Matzel13/BU-Projekt/Bericht/Kapitel/projektarbeit.tex

\section{Herangehensweise}
Für die Umsetzung des Projekts wurde agiles Projektmanagement gewählt. Im Rahmen der agilen Entwicklung wurden wöchentliche Sprints festgelegt, in denen Gruppenmitglieder den Fortschritt der jeweiligen Aufgaben präsentieren. Dies ermöglicht es, bei auftretenden Problemen gemeinsam Lösungen zu erarbeiten. Durch diese Struktur lassen sich Projektziele dynamisch anpassen, wodurch eine schnelle Reaktion auf Probleme oder Engpässe gewährleistet ist.\\

Zu Beginn wurde ein Endziel definiert, das in Abschnitt \ref{sec:vision} beschrieben ist und auf das konsequent hingearbeitet wird. Innerhalb des ersten Sprints konnte erfolgreich eine einfache Datenübertragung zwischen einem ESP32 und einem Arduino-Nano hergestellt werden.\\

In den darauf folgenden zwei Sprints wurde ein erster einfacher Prototyp des Busses entwickelt. Dieser umfasste einen Eindraht-Bus, wobei die Software zu diesem Zeitpunkt lediglich unidirektionale Kommunikation zwischen einem Sender und mehreren Empfängern unterstützte.\\

Im weiteren Verlauf des Projekts wurden Tasten sowie zusätzliche Teilnehmer auf dem Prototyp implementiert. Die Tasten dienten der Simulation verschiedener Busteilnehmer. Jedem Taster wurde ein Mikrocontroller (ATtiny oder ATmega) zugeordnet, um die Adressierung der unterschiedlichen Module zu entwickeln und zu validieren. Das gewünschte Verhalten bestand darin, dass ausschließlich der Mikrocontroller mit der entsprechenden Adresse aktiviert wird, wodurch eine LED zum Leuchten gebracht wird.\\

Anschließend wurde der Prototyp um eine weitere Busleitung erweitert und die differenzielle Datenübertragung angegangen. Hierbei sind einige Schwierigkeiten bezüglich der Hardware aufgetreten. Nach einem Neubau des Prototyps auf dem Breadboard und Reduzierung der Teilnehmer aufgrund von Platzmangel auf dem Breadboard ließ sich ein Keypad-Modul und der Hauptcontroller aufbauen (Abb. \ref{prototyp}). \\
Mit diesem Stand des Prototyps lässt sich ein 2x2 Keypad beliebig belegen und zum Beispiel eine PowerPoint-Präsentation steuern.

\begin{figure}[H]
    \centering    
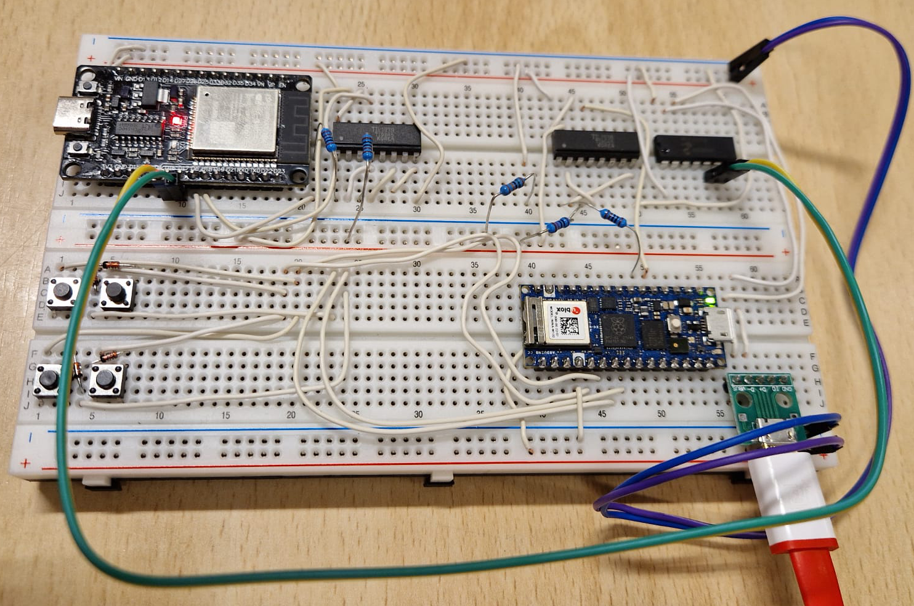
[picture p3: Bericht/Bilder/buPrototyp.png]
    \fbox{}
    \caption{Entwicklungs-Prototyp zum Stand des Zwischenberichts}
    \label{prototyp}
\end{figure}

Nach Bestellen der PCBs kann ein erster richtiger Aufbau der Module realisiert werden und auch die Funktionalität der Hardware Bedingungen (Pogo-Pin Verbindung und magnetische Halterung) können nun getestet werden. Die PCBs sind, aufgrund des Budget, teilbestückt bestellt worden, daher werden diese jetzt von Hand final bestückt.

\subsection{Erfolge}
\subsubsection{Synchronisation}
Zur Synchronisation des Empfängers mit dem Sender haben wir eine Funktion geschrieben, welche bei einem HIGH-Value auf dem Bus einen Zeitstempel setzt und sobald der Bus auf LOW fällt, die Übertragungsgeschwindigkeit ausrechnet. Damit wird sichergestellt, dass die übertragenen Bits richtig ausgelesen werden.

\subsubsection{Datenübertragung}
Durch die selbst geschriebene Software lassen sich in der Theorie beliebig große Datenmengen übertragen, solange die Anzahl an Datenbytes im Code festgelegt wurde. In der Praxis sind große Datenmengen vermutlich problematisch, da die Synchronisation nur zu Beginn des Frames stattfindet. Da wir in unserem Projekt nur Eingabewerte übertragen, welche 8 Byte nicht überschreiten werden, haben wir uns auf ein Maximum von 8 Byte festgelegt. Sollte sich an einem zukünftigen Entwicklungspunkt herausstellen, dass wir mehr Daten übertragen wollen, lässt sich das leicht anpassen, aber es sollte auch eventuell eine Neusynchronisation überlegt werden. 

\subsubsection{Adressvergabe und Polling loop}
Das Hauptmodul startet eine dauerhafte vordefinierte Abfrage der Adressen. Über die erste abgefragte Adresse wird einem neuen Modul eine Adresse vergeben und diese mit der Art des Moduls in Hauptmodul abgespeichert. Die erhaltenen Werte der Module gibt das Hauptmodul zusammen mit der Modul-Adresse an den PC weiter.

\subsubsection{Input-Mapper Program}
Als Bedienoberfläche wurde ein Programm geschrieben, welches die empfangenen Daten auf die vom Nutzer definierte Keybindings mappt.

\subsubsection{Parallele Entwicklung}
Das parallele Entwickeln war durch das Verwenden des Versionsverwaltungs-Programms \glqq Git\grqq{} und einem zentralen Repository auf \glqq GitHub\grqq{}(https://github.com/Matzel13/BU-Projekt) von Beginn an erfolgreich und hat sich durch die Länge des Projekts gezogen. Durch das Erstellen von persönlichen \glqq Branches\grqq{} konnte jeder Entwickler an seinem eigenen Fortschritt arbeiten und bei Bedarf mit dem Hauptzweig zusammenführen. In Abb. \ref{gitgraph} ist ein Ausschnitt des GitGraphen unseres Repository zu sehen.

\begin{figure}[H]
    \centering    
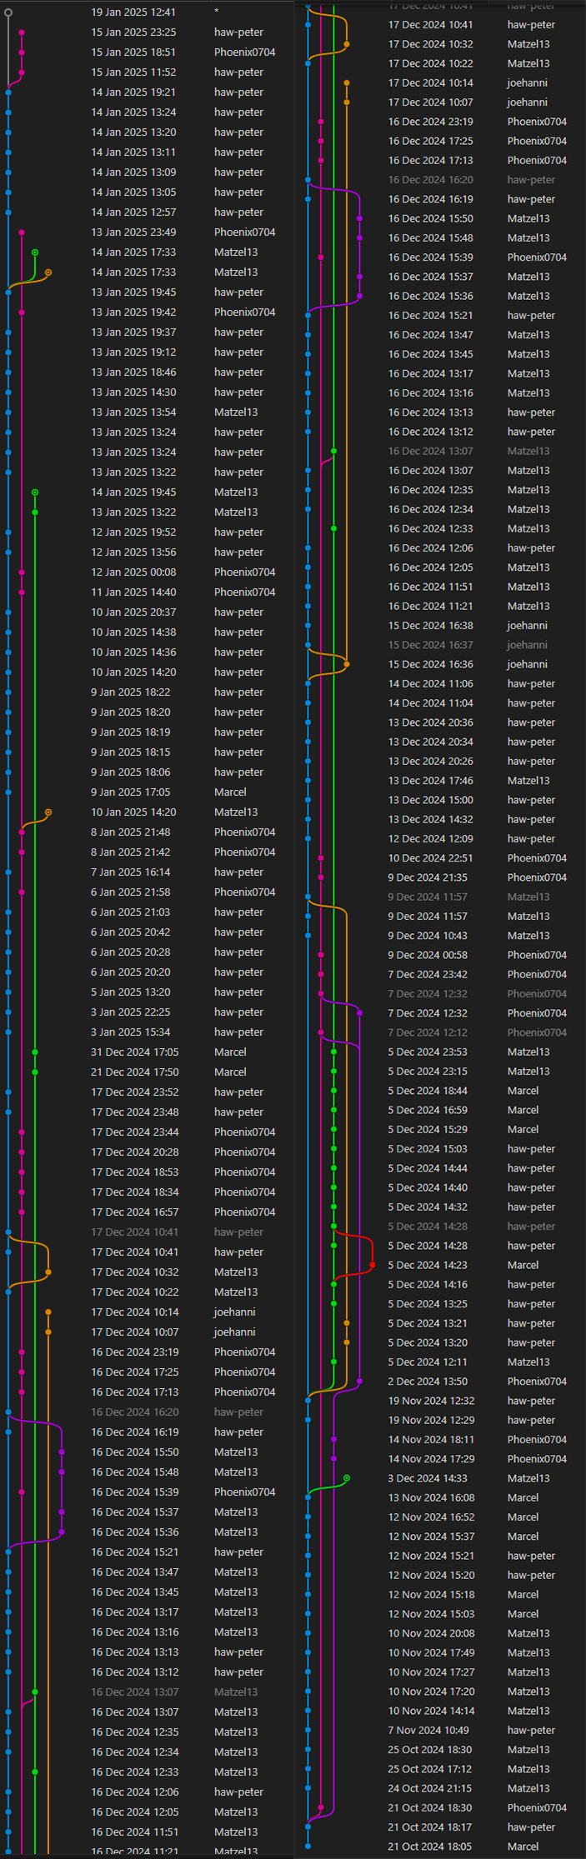
[picture p4: Bericht/Bilder/gitGraph.png]
    \fbox{}
    \caption{GitGraph stand 19.01.2025. Die Linie links stellen die Unterschiedlichen Branches dar. Ein Punkt auf der Linie bedeutet, dass dort ein Commit erstellt wurde. Das Datum ist das Commitdatum und der Name der Person, die den Commit erstellt hat.}
    \label{gitgraph}
\end{figure}

\subsection{Probleme}
\subsubsection{ATtiny und ATmega}
Die eingesetzten Mikrocontroller (ATtiny und ATmega) lassen sich nicht direkt über USB programmieren. Aus diesem Grund wurde innerhalb zwei Sprints versucht, einen eigenen ISP-Programmer (In-System Programmer) zu entwickeln. Trotz vieler verfügbarer Anleitungen und Forenbeiträge zu bereits selbstgebauten Flashern gelang es nicht innerhalb des vorgegebenen Zeitrahmens, einen funktionierenden Programmer zu erstellen. Schließlich wurde ein fertiger ISP-Programmer gekauft, wodurch die Programmierung der Mikrocontroller schnell und erfolgreich möglich wurde.

\subsubsection{Differenzielle Datenübertragung}
Der erste Ansatz zum Erstellen einer differenziellen Datenübertragung war es, dies über die Software zu lösen. Jedoch kam nach gemeinsamer Absprache der Entschluss, dass dies nicht sonderlich förderlich sei und hauptsächlich der Geschwindigkeit des Busses schadet. Bei der Erweiterung des Eindraht Prototypen auf einen Zweidraht Bus mit differenzieller Datenübertragung entstand das Problem, dass in einigen Fällen die Busleitung kurzgeschlossen wird. Dieser Kurzschluss lässt sich durch galvanische Trennung der Teilnehmer vom Bus, ähnlich wie beim CAN und USB, lösen. Um weiterhin mit den zur Verfügung gestellten Produkten zu arbeiten, wurde erstmal ein Optokoppler der HAW getestet. Scheinbar war dieser Optokoppler defekt, da sich die Schaltzeiten im \si{ms} Bereich bewegt haben. Dies wäre ein viel zu hohe Latenz für die Datenübertragung und daher wurden vier mögliche alternative Bausteine bestellt, zwei verschiedene Optokoppler, einen Operationsverstärker und einen digitalen Isolator. Die Optokoppler lieferten ein zufriedenstellendes Ergebnis mit einer Latenz im einstelligen \si{\micro\second} Bereich. Zusätzlich zu den Optokopplern wurde ein Transmitter und Receiver Bauteil entdeckt, da jedoch die Lieferzeit für diese Bauteile sehr hoch ist, werden diese Bauteile vom PCB Hersteller direkt auf das PCB designt, welches das Testen der Bauteile leider nicht ermöglicht. Der aktuelle Prototyp wurde mit diskret aufgebauten Invertierern und Optokopplern realisiert.

\subsubsection{Ungetestete Bauteile}
Wie im vorherigen Absatz erwähnt, werden Bauteile benutzt, die leider im Vorfeld nicht getestet werden können. Daher wurden Alternativen im PCB-Design implementiert, falls diese Bauteile nicht die Erwartungen erfüllen. Bei der Entwicklung der PCB und der Lösung des Problems der differenziellen Datenübertragung werden die Bauteile der SN65LVDXXX Familie benutzt. Aufgrund der erwähnten Lieferzeit konnten die Bauteile nicht getestet werden. Um etwaige Probleme mit den Bauteilen zu umgehen, werden mehrere Jumper ins Design geplant, um die Bauteile mit Optokopplern oder eine externe Testschaltung oder Testbauteil zu ersetzen.

\subsubsection{Krankheit und Lieferzeiten}
Aufgrund von Krankheiten konnte die Gruppe nicht an jedem Termin vollständig arbeiten, oder musste bereits fertige Pläne umstrukturieren. Zusätzlich kam es zu Verzögerungen durch Lieferzeiten von ein bis zwei Wochen der Bauteile.

%Bild von Zeitplan einfügen PETER EDIT: Zeitplan muss aktualisiert werden MARCEL Edit: mache ich immer schon ;) PETER EDIT: Nice, machen wir nachher rein MarcelEdit: klar ;)
%MarcelEdit: die Tabelle muss nochmal finalisiert und eingefügt werden !!!

Einen groben Übersichtsplan des Zeitmanagements ist in Abbildung \ref{zeitplan} zu sehen. Deutlich erkennbar sind die KW44 und KW48, in denen kein Meeting stattfinden konnte. Zusätzlich sind alle Vorlesungszeiten mit im Plan aufgenommen, da die Vorlesungen teilweise genutzt wurden, um am Projekt zu arbeiten. Der Zeitplan dient lediglich einer groben Analyse der investierten Zeit und hat keinen Einfluss auf das Vorgehen.

\begin{figure}[H]
    \centering    
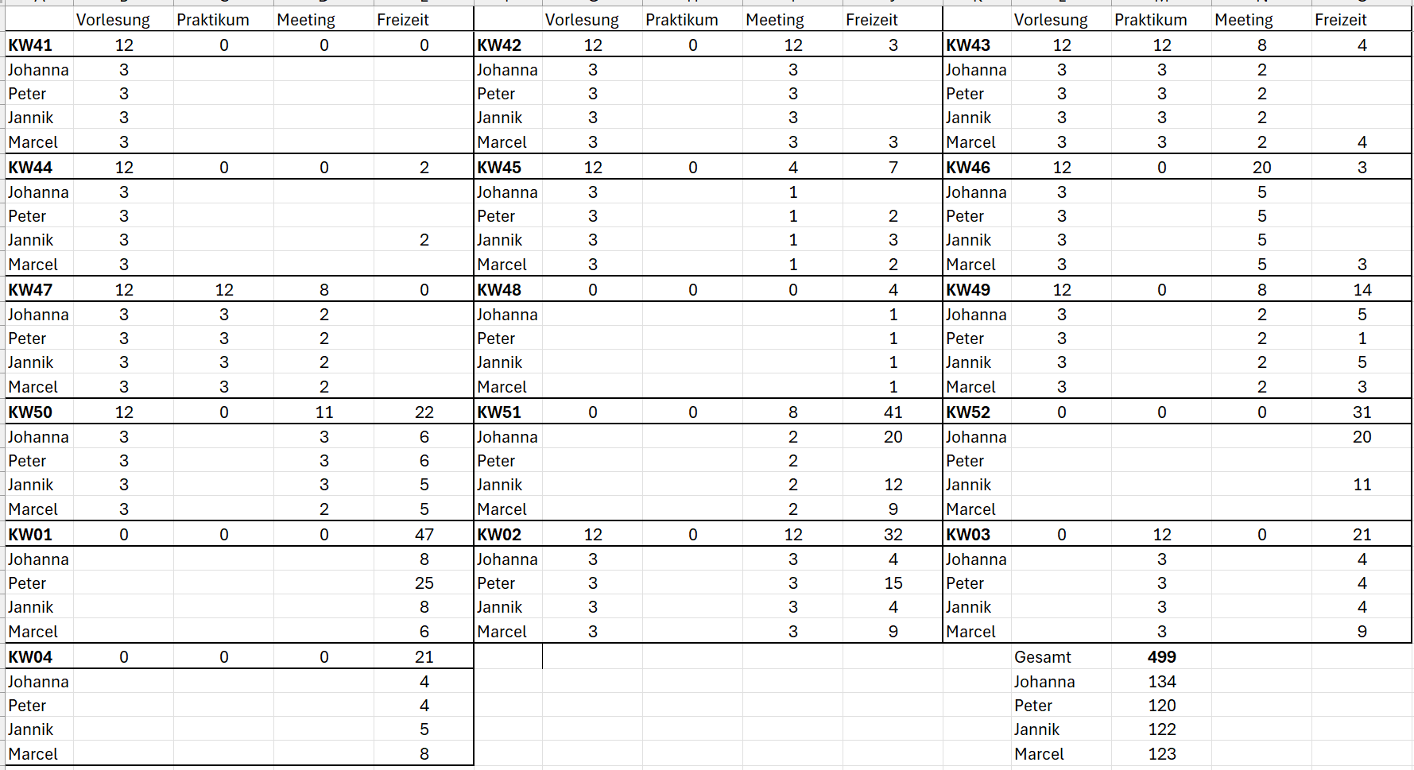
[picture p5: Bericht/Bilder/zeitplanBU.png]
    \fbox{}
    \caption{Zeitmanagement stand 21.01.2025}
    \label{zeitplan}
\end{figure}

\subsection{Budget}
Zur Entwicklung der Testaufbauten und des Prototyps wurden diverse Bauteile bestellt. Da im Anschluss an das Hochschulmodul jedes Gruppenmitglied ein Exemplar behalten wollte, entschieden wir uns das Projekt selbst zu finanzieren. Um die Kosten der Module gering zu halten, wurde bei jeder Entscheidung darauf geachtet, die günstigste Version zu finden. In Abbildung \ref{Finanzen} sind alle Bauteile, die bestellt worden sind, aufgelistet und diese Liste wurde genutzt, um einen Überblick über die Ausgaben zu behalten. Es lässt sich gut erkennen, wie teuer die Modul-Prototypen sind, das Hauptmodul befindet sich derzeitig bei 39,68 € und das Keypad-Modul bei 44,61 €. Diese Preise lassen sich in Zukunft vermutlich noch reduzieren, da die PCBs mit verschiedenen Testcases bestückt sind. In dieser Berechnung sind die Kosten für die Gehäuse nicht berücksichtigt. 

\begin{figure}[H]
	\centering    
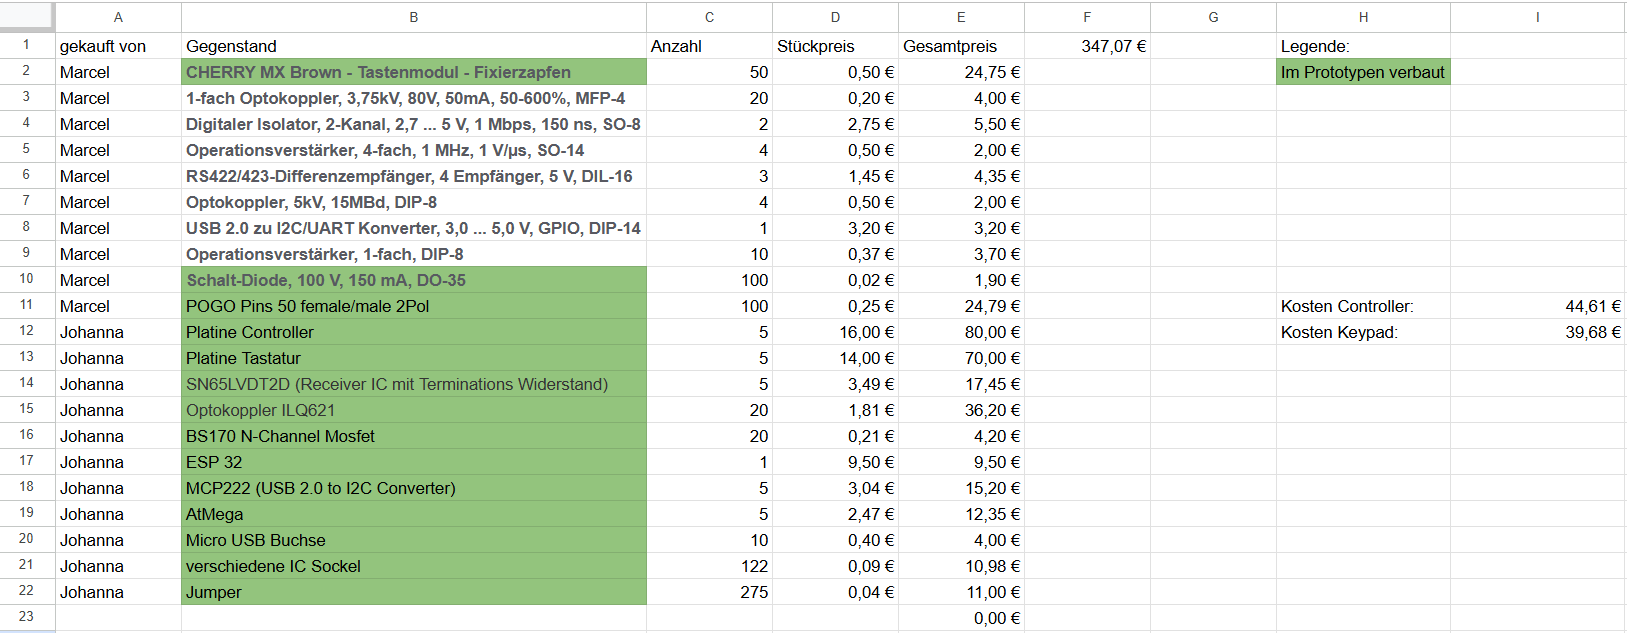
[picture p6: Bericht/Bilder/Finanzen.png]
	\fbox{}
	\caption{Exceltablle der Ausgaben, stand 19.01.2025. Darstellung der gekauften Bauteile und von wem diese gekauft wurden. Mit Grün hinterlegte Felder sind auf dem aktuellen Prototyp verbaute Bauteile. In F1 steht der Gesamtbetrag der bisher investiert wurde}
	\label{Finanzen}
\end{figure}

Das Produkt lässt sich sehr gut mit dem Stream Deck von elgato vergleichen. Bei einer möglichen Vermarktung unseres Produktes kann sich an dem Preis des Streamdeck orientiert werden. Dazu ist in Abbildung \ref{streamDeck} der offizielle Preis des 3x5 Keypad Stream Deck von elgato dargestellt.

\begin{figure}[H]
	\centering    
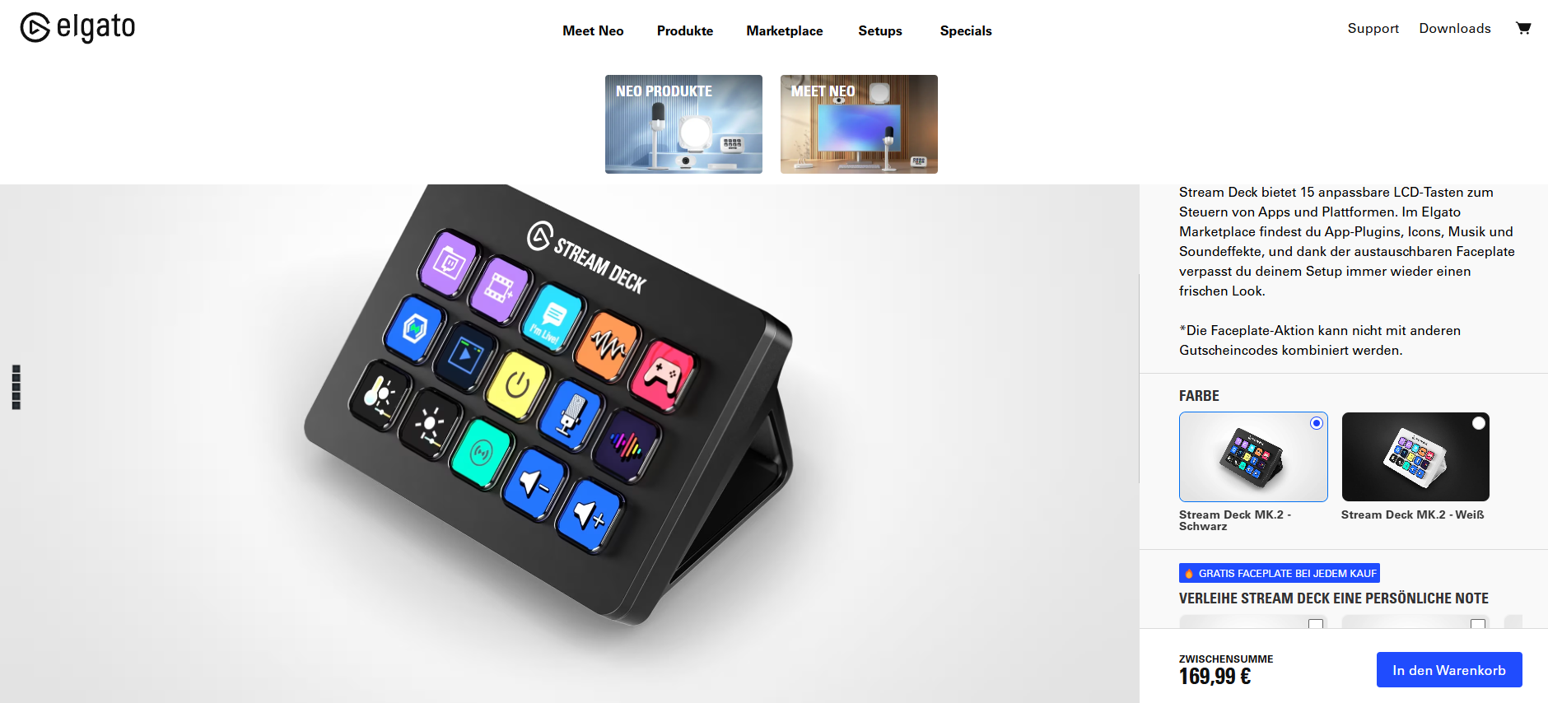
[picture p7: Bericht/Bilder/streamDeck.png]
	\fbox{}
	\caption{Stream Deck Preis von elgato. Dies dient lediglich als Vergleich, in welcher Preis-Kategorie unser Produkt vermakrtet werden könnte. [https://www.elgato.com/de/de/p/stream-deck-mk2-black, 19.01.2025]}
	\label{streamDeck}
\end{figure}

Mit dem Vergleich des elgato Produkts lässt sich ein Vermarktungspreis von ca. 200 € für das Hauptmodul und Keypad Modul in Kombination festlegen. Dies lässt sich durch unsere Modularität und Erweiterungsmöglichkeiten begründen. Weitere Module sollten einen Einzelpreis von ca. 60-80 € erhalten.
Dies sind bisher allerdings lediglich Überlegungen, da wir uns noch in der Forschungsperiode befinden.

\subsection{Weiteres Vorgehen}
Wir wollen das Produkt auch nach Abschluss des Faches \glqq Bussysteme und Sensorik\grqq{} weiterentwickeln, da wir großes Potential sehen dies auch in Zukunft vermarkten zu können.

Als nächstes wollen wir eine intensive Testphase des Prototypen durchführen. Dazu werden wir 5 Prototypen aufbauen und diese auch an externe Personen verteilen um eine größtmögliche Menge an Feedback Daten zu erhalten.
Während der letzten Monate konnten wir bereits durch Gespräche mit Freunden mehrere interessierte Tester ausfindig machen. \\

Geplant ist, die Platinen durch Optimierung der Schaltung und Verwendung von möglichst vielen SMD Bauteilen kleiner und günstiger zu machen und um die Modularität zu optimieren. Außerdem soll die Möglichkeit der Kabelverbindung zwischen den Modulen umgesetzt werden, um dem Nutzenden möglich hohe Flexibilität zu ermöglichen. \newline 

Das Input-Mapper Programm bekommt noch weitere Features, zum Beispiel die Möglichkeit eine Zeitverzögerung in die Tastenkombination mit einzubauen.
\\\\
Im Anschluss an die oben genannten Punkte wird mit der Entwicklung weiterer Module begonnen. Durch die verallgemeinerte Entwicklung des ersten Moduls sollte die Entwicklung weiterer Module relativ einfach sein, da sich lediglich mit der Funktion des Moduls auseinandergesetzt werden muss. Der Kommunikation zwischen dem Modul-Mikrocontrollers und dem Hauptmodul ist im Grunde die gleiche.
