Matzel13/BU-Projekt/Bericht/Kapitel/vision.tex

\chapter{Modulares Eingabesystem}
\section{Projektbeschreibung}\label{sec:vision}
Das Eingabesystem verfolgt die Vision eines flexiblen und erweiterbaren Systems, das sich an die individuellen Bedürfnisse der Benutzer anpasst. Im Zentrum steht ein Hauptmodul, das als Mikrocontroller-Einheit dient und über eine USB-Schnittstelle mit einem Computer verbunden wird. Dieses Hauptmodul koordiniert die Kommunikation und Funktionalität der verbundenen Module.
\\
\\
Die Module, wie ein Tastatur-Modul mit einer 4x4-Tastenmatrix oder ein Audio-Modul mit Potentiometern und Fadern, sind frei kombinierbar und können je nach Anwendungsfall hinzugefügt oder entfernt werden. Dies ermöglicht eine Konfiguration für unterschiedliche Aufgaben wie Textverarbeitung, Bildbearbeitung, Audiobearbeitung oder Gaming.
\\
\\
In Abbildung \ref{vision} ist ein Überblick des Eingabesystems zu sehen.
\begin{figure}[H]
    \centering    
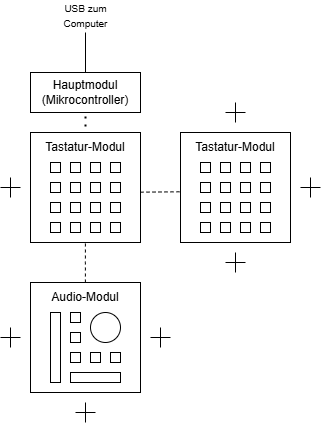
[picture p19: Bericht/Bilder/bu_vision.png]
    \fbox{}
    \caption{Vereinfachte Darstellung des Eingabesystems}
    \label{vision}
\end{figure}
\noindent Die gestrichelten Linien stellen eine bereits hergestellte Verbindung zwischen den Modulen dar, wobei die \glqq Plus\grqq{} Symbole einen weiteren möglichen Modulanschluss darstellen. Die Module sollen fest aneinander sitzen.

\subsection{Verbindung}
Zwischen den Modulen werden Daten und Spannungsversorgung über eine 4 Pin-Verbindung realisiert. Diese sind VCC (Spannungsversorgung), Data + (Datenbus), Data - (invertierter Datenbus) und GND (Masse). Da der Benutzer die Möglichkeit haben soll, an jede Seite eines Moduls ein weiteres anzustecken, werden pro Seite zwei 2-Pin Pogo Stecker verwendet, ein 2-Pin Male und ein 2-Pin Female Stecker. Dadurch ist das System in jede Richtung erweiterbar. Um eine feste Verbindung zu gewährleisten,  werden Neodym-Magnete ins Gehäuse verbaut. Dies stellt sicher, dass die Pins fest miteinander verbunden sind und Kontakt haben. Zusätzlich soll mit einem Verlängerungskabel auch die Möglichkeit bestehen, eine kurze Distanz (< 50 cm) zwischen zwei Modulen zu haben. 
\begin{figure}[H]
    \centering    
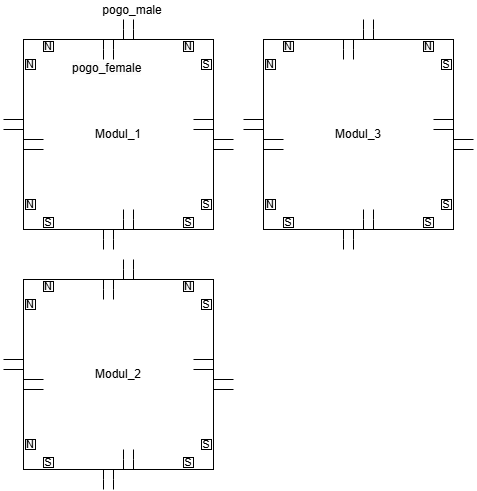
[picture p20: Bericht/Bilder/bu_pogoverbindung.png]
    \fbox{}
    \caption{Verbindung der Module durch Pogo-Stecker und Magnete}
    \label{pogo_verbindung}
\end{figure}
 \noindent Abbildung \ref{pogo_verbindung} zeigt, dass die Steckverbindungen eine nahezu beliebige Anordnung der Module zulassen. Durch die Anordnung der Magneten lassen sich nicht alle Module in jeder beliebigen Anordnung verbinden, wie z.B. Oberseite und Oberseite, die aufgrund der physikalischen Eigenschaften der Magnete nicht verbunden werden können. Die \glqq N\grqq{} und \glqq S\grqq{} Symbole stellen die im Gehäuse verbauten Magneten (Nord- und Südpol) zum Zusammenhalt der Module dar.

 \subsection{Topologien}
 Der Hardware-Aufbau des Eingabesystems entspricht einer Vermaschten-Topologie. Das verdeutlicht die Abbildung \ref{vision}, denn mit jedem neuen Modul kann auch eine Verbindung zu einem schon vernetzen Modul entstehen. Die Vorteile dieser Topologie werden im Gesamtsystem nicht genutzt, denn die Vermaschung kommt lediglich durch die notwendige Verbindung der Module untereinander zustande.\\
\begin{figure}[H]
	\centering    
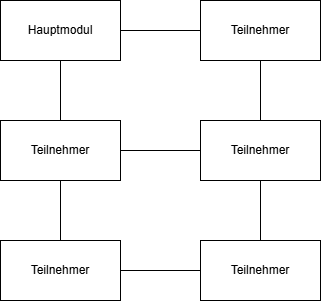
[picture p21: Bericht/Bilder/vermaschte_topologie.png]
	
	\caption{Vermaschte Topologie}
	\label{vermaschte_topologie}
\end{figure}

 Der Bus hingegen nutzt die Bus-Topologie, denn alle Teilnehmer sind über den Bus miteinander verbunden. Dies hat die Vorteile:
\begin{itemize}
    \item\textbf{Einfache Installation:} Weniger Kabel und einfacher Aufbau, da alle Geräte an einer gemeinsamen Leitung (Bus) angeschlossen sind.
    \item\textbf{Einfache Erweiterung:} Neue Geräte können leicht angeschlossen werden. 
    \item\textbf{Effizient für kleine Netzwerke:} Gut geeignet für kleine Netzwerke mit wenigen Geräten. 
\end{itemize}
Mit einem Nachteil der Störanfälligkeit. Da der Bus als zentrale Verbindung genutzt wird, können beispielsweise Schäden am Bus die Störanfälligkeit erhöhen und die Verbindung beeinträchtigen. Es gilt, diese Schwachstelle bestmöglich zu schützen.\\
\begin{figure}[H]
	\centering    
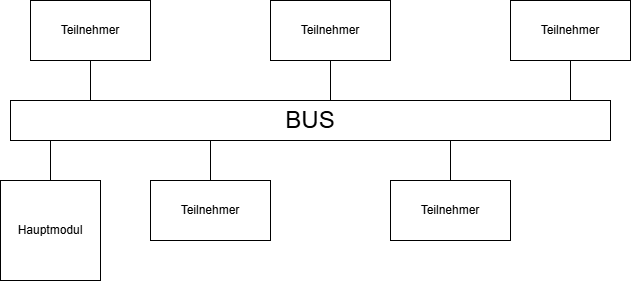
[picture p22: Bericht/Bilder/bustopologie.png]
	
	\caption{Bustopologie}
	\label{Bustopologie}
\end{figure}

Auf der Softwareebene ist das Konzept nach der Stern-Topologie aufgebaut, denn das Hauptmodul ist eine zentrale Steuereinheit, an die alle anderen Module angeschlossen sind. Die verschiedene Module sind jeweils direkt an den Bus angebunden. Die Verbindungen laufen sternförmig von dem Hauptmodul zu den einzelnen Modulen. Die Vorteile einer Stern-Topologie in diesem Projekt sind:
\begin{itemize}
    \item \textbf{Skalierbarkeit:} Weitere Module können einfach an das Hauptmodul angeschlossen werden.
    \item \textbf{Einfache Fehlersuche:} Da jedes Modul eine direkte Verbindung zum Hauptmodul hat, ist der Ausfall eines Moduls leichter zu erkennen.
    \item \textbf{Kontrolle:} Alle Daten laufen durch das Hauptmodul.
\end{itemize}
Wobei nur ein Nachteil festgestellt werden kann:
\begin{itemize}
    \item \textbf{Abhängigkeit:} Fällt das Hauptmodul aus, funktioniert das gesamte System nicht mehr.
\end{itemize}
\begin{figure}[H]
	\centering    
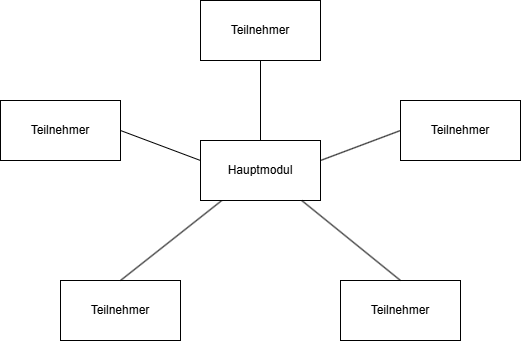
[picture p23: Bericht/Bilder/sterntopologie.png]
	
	\caption{Sterntopologie}
	\label{Sterntopologie}
\end{figure}
