Matzel13/BU-Projekt/Bericht/sample.tex

\documentclass[draft=false
              ,paper=a4
              ,twoside=false
              ,fontsize=11pt
              ,headsepline
              ,BCOR=10mm
              ,DIV=11
              ]{scrbook}
\usepackage[ngerman,english]{babel}
%% see http://www.tex.ac.uk/cgi-bin/texfaq2html?label=uselmfonts
\usepackage[T1]{fontenc}
\usepackage[utf8]{inputenc}
\usepackage{libertine}
\usepackage{pifont}
\usepackage{microtype}
\usepackage{textcomp}
\usepackage[german,refpage]{nomencl}
\usepackage{setspace}
\usepackage{makeidx}
\usepackage{listings}
\usepackage{natbib}
\usepackage[ngerman,colorlinks=true]{hyperref}
\usepackage{soul}
\usepackage{hawstyle}
\usepackage{float}
\usepackage{lipsum} %% for sample text
\usepackage{parskip}
\usepackage{amsmath}
\usepackage{siunitx}

%% define some colors
\colorlet{BackgroundColor}{gray!20}
\colorlet{KeywordColor}{blue}
\colorlet{CommentColor}{black!60}
%% for tables
\colorlet{HeadColor}{gray!60}
\colorlet{Color1}{blue!10}
\colorlet{Color2}{white}

%% configure colors
\HAWifprinter{
  \colorlet{BackgroundColor}{gray!20}
  \colorlet{KeywordColor}{black}
  \colorlet{CommentColor}{gray}
  % for tables
  \colorlet{HeadColor}{gray!60}
  \colorlet{Color1}{gray!40}
  \colorlet{Color2}{white}
}{}
\lstset{%
  numbers=left,
  numberstyle=\tiny,
  stepnumber=1,
  numbersep=5pt,
  basicstyle=\ttfamily\small,
  keywordstyle=\color{KeywordColor}\bfseries,
  identifierstyle=\color{black},
  commentstyle=\color{CommentColor},
  backgroundcolor=\color{BackgroundColor},
  captionpos=b,
  fontadjust=true
}
\lstset{escapeinside={(*@}{@*)}, % used to enter latex code inside listings
        morekeywords={uint32_t, int32_t}
}
\ifpdfoutput{
  \hypersetup{bookmarksopen=false,bookmarksnumbered,linktocpage}
}{}

%% more fancy C++
\DeclareRobustCommand{\cxx}{C\raisebox{0.25ex}{{\scriptsize +\kern-0.25ex +}}}

\clubpenalty=10000
\widowpenalty=10000
\displaywidowpenalty=10000

% unknown hyphenations
\hyphenation{
}

%% recalculate text area
\typearea[current]{last}

\makeindex
\makenomenclature

\begin{document}
\selectlanguage{ngerman}

%%%%%
%% customize (see readme.pdf for supported values)
\HAWThesisProperties{Author={Johanna Böttcher, Marcel Eßmann,\\ Peter Fischer, Jannik Wendt}
                    ,Title={Modulares Eingabesystem}
                    ,EnglishTitle={Developing software in Germany}
                    ,ThesisType={Bussysteme und Sensorik - Projekt}
                    ,ExaminationType={Bachelorprüfung}
                    ,DegreeProgramme={Bachelor of Science Angewandte Informatik}
                    ,ThesisExperts={Prof. Dr. Robert Fitz}
                    ,ReleaseDate={17. Dezember 2024}
                  }

%% title
\frontmatter

%% output title page
\maketitle

\onehalfspacing

%% add abstract pages
%% note: this is one command on multiple lines
%% enable if these lists should be shown on their own page
%%\listoftables
\tableofcontents
\listoffigures
\lstlistoflistings

%% main
\mainmatter
\onehalfspacing
%% write to the log/stdout
\typeout{===== File: chapter 1}
%% include chapter file (chapter1.tex)
%%\include{chapter1}

%%%%%%%%%%%%%%%%%%HIER DIE INCLUDES REIN %%%%%%%%%%%%%%%%%%%%%%%%%%%%%%%

%REIHENFOLGE HIER ÄNDERN!
\include{Kapitel/einleitung}
\include{Kapitel/vision}
\include{Kapitel/projektarbeit}
\include{Kapitel/datenbus}
%\include{Kapitel/aktueller_stand}
\include{Kapitel/programme}
\include{Kapitel/Keymapper}
\include{Kapitel/Schaltplan}
\include{Kapitel/fazit}
\include{Kapitel/anhang}

%%%%

%% appendix if used
%%\appendix
%%\typeout{===== File: appendix}
%%\include{appendix}

% bibliography and other stuff
\backmatter

\typeout{===== Section: literature}
%% read the documentation for customizing the style
\bibliographystyle{dinat}
%\bibliography{sample}
\typeout{===== Section: nomenclature}
\end{document}
