Matzel13/BU-Projekt/Bericht/Kapitel/anhang.tex

\chapter{Anhang}
\subsection{Main Programm}
\lstinputlisting[language=c++, caption={main.cpp}, label={main.cpp}]{Kapitel/Programme/main.cpp}
\newpage
\subsection{Main Header}
\lstinputlisting[language=c++, caption={header.h}, label={header.h}]{Kapitel/Programme/header.h}
\newpage
\subsection{Input Mapper}
\lstinputlisting[language=python, caption={Input-Mapper Program; Durch die Formatierung in LaTeX lässt sich dieser schwierig lesen, am besten die mitgelieferte Python Datei öffnen und anschauen.}, label={main.py}]{Kapitel/Programme/main.py}
