Matzel13/BU-Projekt/Bericht/Bilder/BU_ESP.PNG

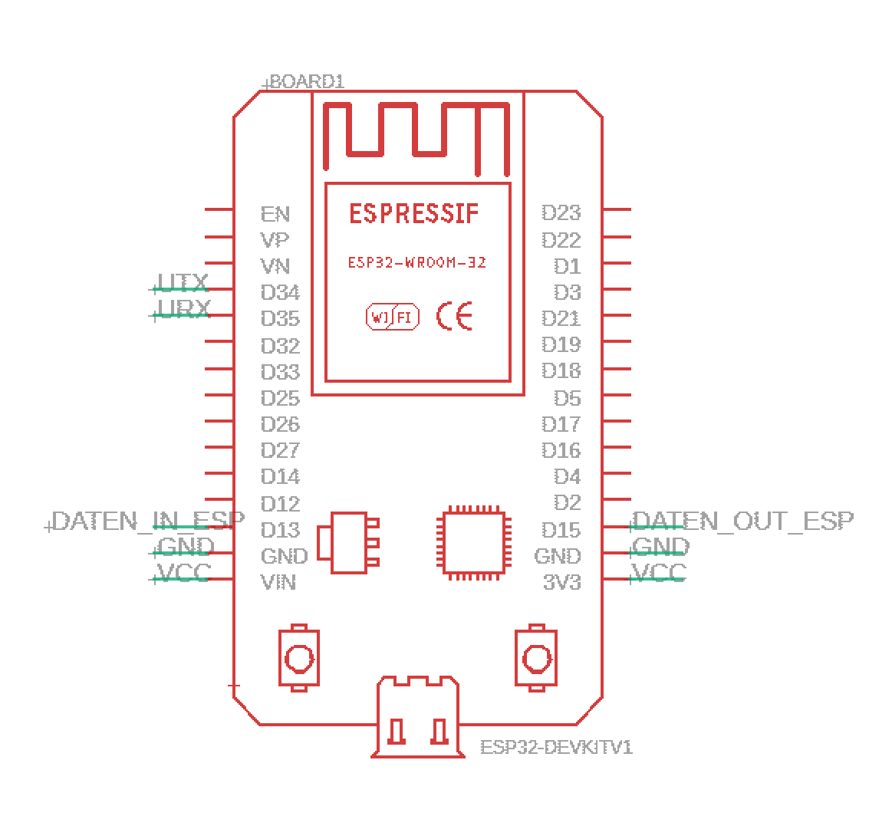
Bericht/Bilder/BU_ESP.PNG
