Matzel13/BU-Projekt/Bericht/Bilder/BU_Kondensatoren_Tastatur.PNG

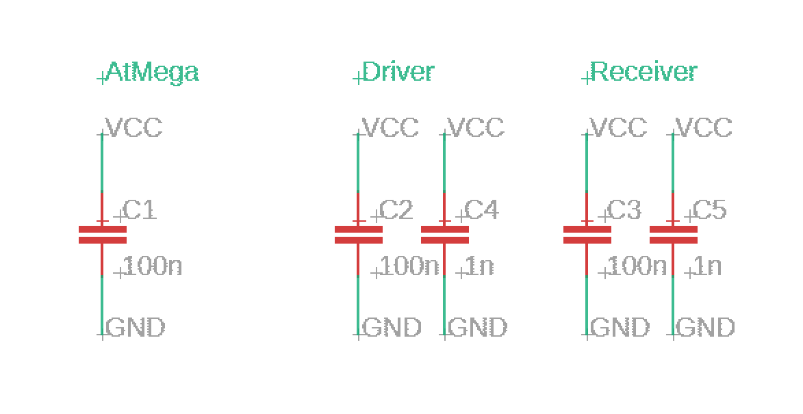
Bericht/Bilder/BU_Kondensatoren_Tastatur.PNG
