Matzel13/BU-Projekt/Bericht/Bilder/BUebersicht.drawio.png

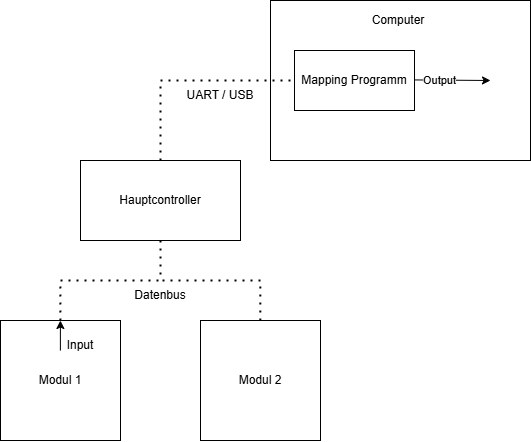
Bericht/Bilder/BUebersicht.drawio.png
