Matzel13/BU-Projekt/Bericht/Bilder/buGitGraph.png

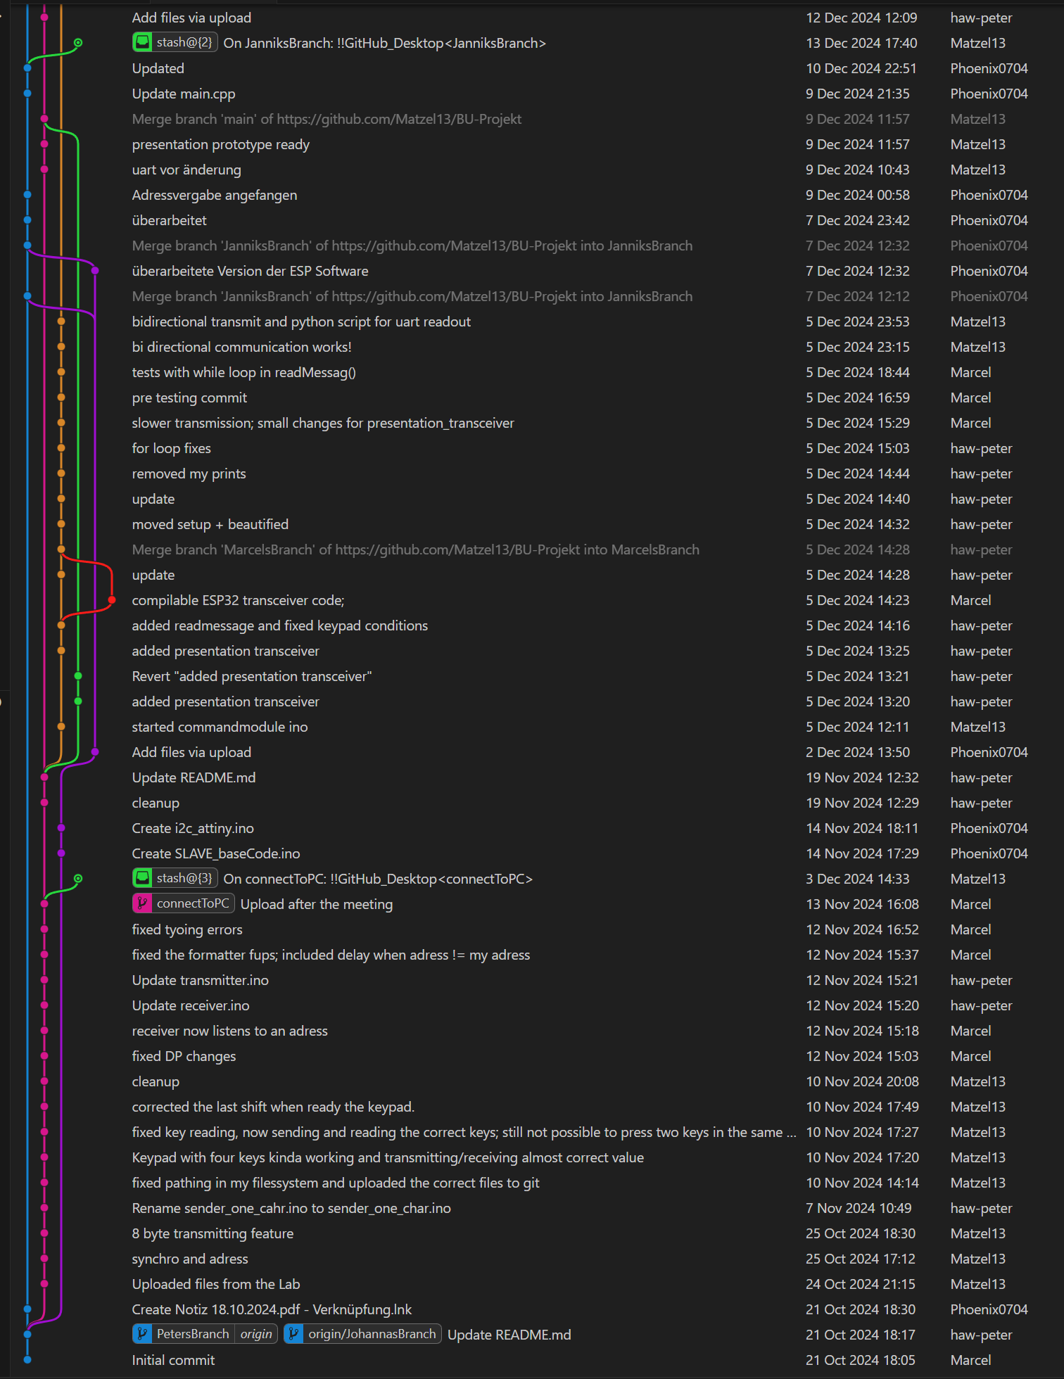
Bericht/Bilder/buGitGraph.png
