Matzel13/BU-Projekt/Bericht/Bilder/buPrototyp.jpeg

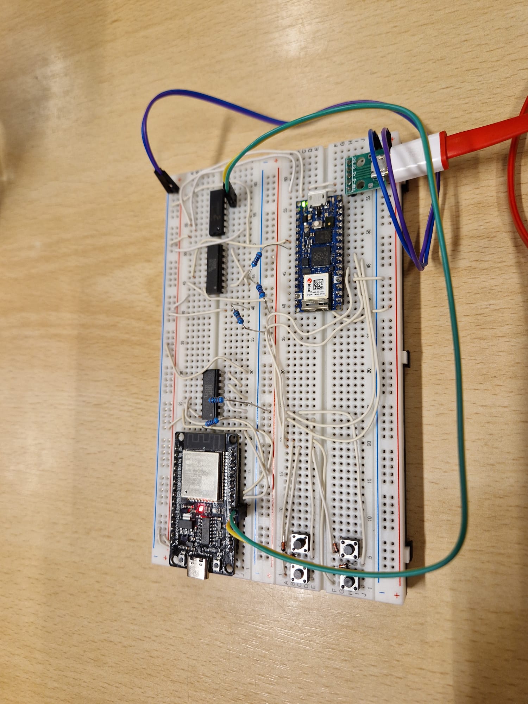
Bericht/Bilder/buPrototyp.jpeg
