Matzel13/BU-Projekt/Bericht/Bilder/Controller.png

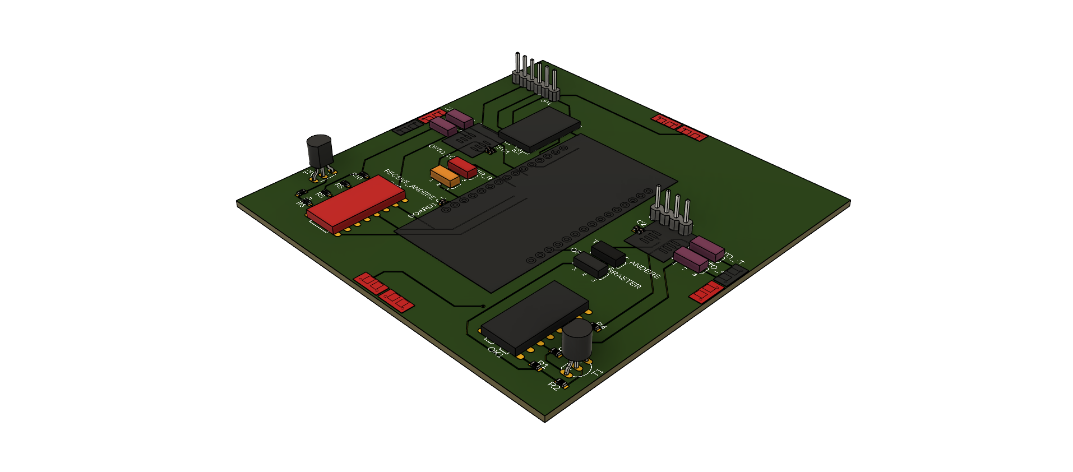
Bericht/Bilder/Controller.png
