Matzel13/BU-Projekt/Bericht/Bilder/Datenaustausch.png

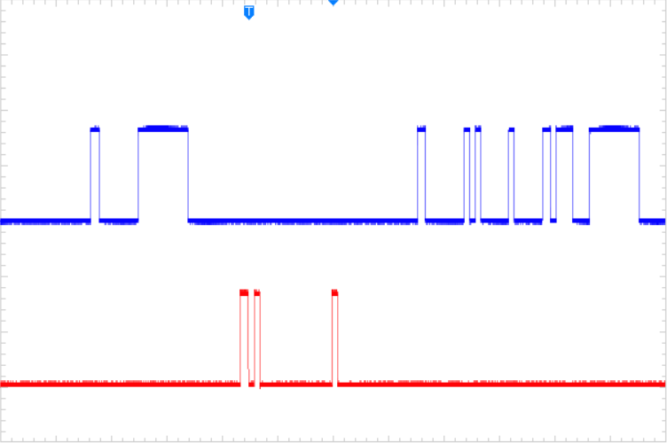
Bericht/Bilder/Datenaustausch.png
