Matzel13/BU-Projekt/Bericht/Bilder/Tastatur.png

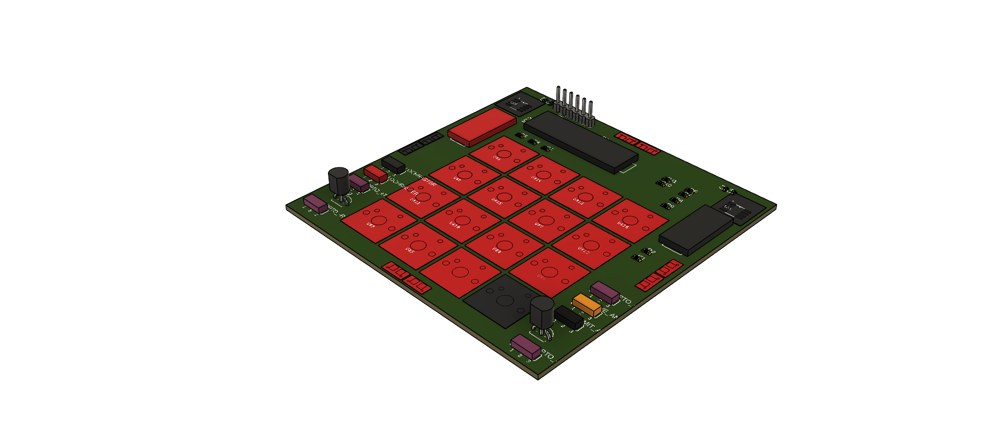
Bericht/Bilder/Tastatur.png
