Matzel13/BU-Projekt/(commit log)

2024-11-10 fixed pathing in my filessystem and uploaded the correct files to git
    [receiver.ino, transmitter.ino]
2024-11-10 Keypad with four keys kinda working and transmitting/receiving almost correct value
    [receiver.ino, transmitter.ino]
2024-11-10 fixed key reading, now sending and reading the correct keys; still not possible to press two keys in the same col
    [transmitter.ino]
2024-11-10 corrected the last shift when ready the keypad.
    [transmitter.ino]
2024-11-12 fixed the formatter fups; included delay when adress != my adress
    for fups see lines 73-82
    [receiver.ino]
2024-12-09 uart vor änderung
2024-12-09 presentation prototype ready
2024-12-16 imported uart.py into programme
2024-12-16 überarbeitete reihenfolge der kapitel
2024-12-16 projektarbeit and sample updated
2025-01-03 added reset button
2025-01-07 added com port checks, added info button
2025-01-09 Revert "threading"
    This reverts commit 7daba912e1edb0a58a02a6d1b719ecb44ede66b9.
    [main.py]
2025-01-09 Revert "com port reading"
    This reverts commit 587bdc9e10792eaf671c7cb6423c2debc45afa3e.
    [main.py]
2025-01-13 arduino code
2025-01-13 fixed loading, saving, beautifer
    [main.py]
2025-01-13 fixed save and load
    [main.py]
2025-01-14 added windows button
2025-01-14 Debug variable for prints
2025-01-21 Verbesserungen
    Formel, Bild und Topology
